Cogito-ergo-sum25/Single-lead-electrocardiograph-with-PCB-design/media/WhatsApp Image 2026-02-04 at 1.03.57 AM (1).jpeg

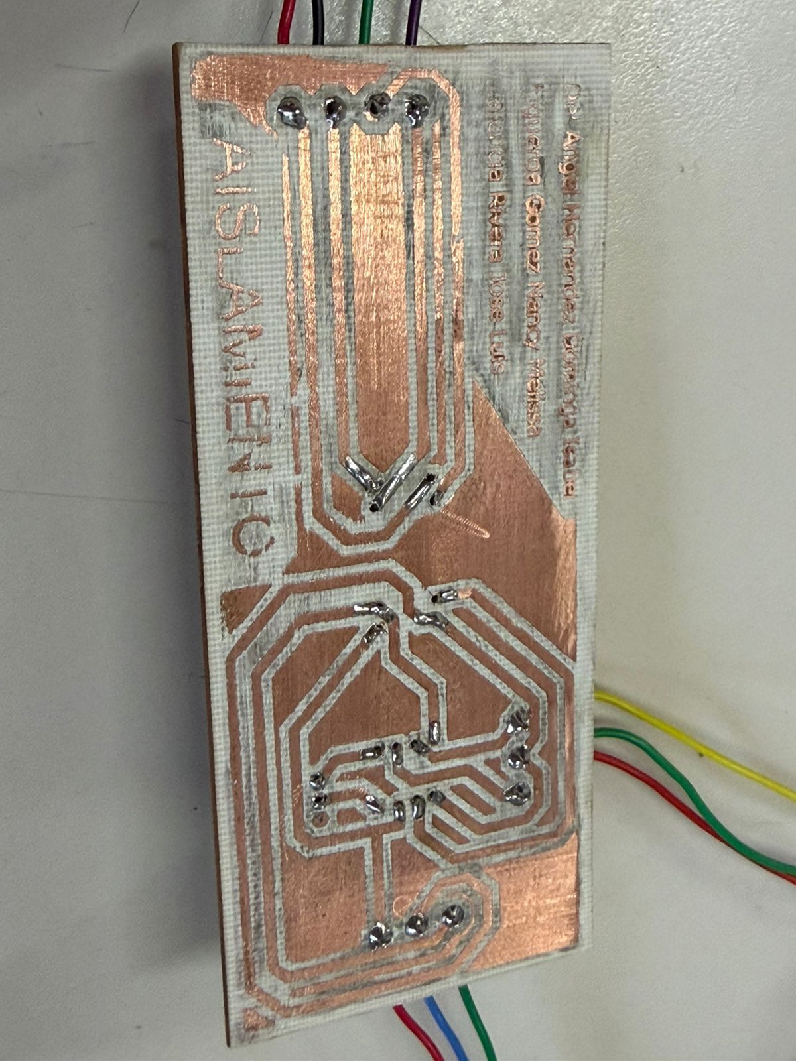
media/WhatsApp Image 2026-02-04 at 1.03.57 AM (1).jpeg
