Cogito-ergo-sum25/Single-lead-electrocardiograph-with-PCB-design/docs/PROYECTO_BIO_I.pdf

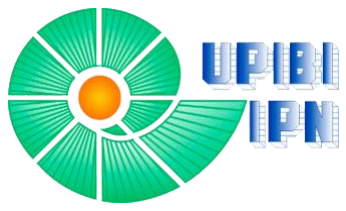
[picture p3: figure]

I. OBJETIVOS

General:

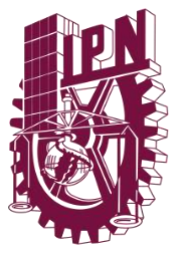
[picture p4: figure]

## INSTITUTO POLITÉCNICO NACIONAL

# Unidad Profesional Interdisciplinaria de Biotecnología

# Bioinstrumentación I

# Laboratorio de Bioinstrumentación I

# Proyecto

# Electrocardiógrafo de una derivación con diseño en PCB

# Presenta:

# Valencia Rivera Jose Luis

Implementar un sistema de adquisición de señales electrocardiográficas (ECG) enfocado en la detección y visualización de la Derivación I, integrando una etapa de paciente (amplificación y aislamiento) en circuito impreso (PCB) y una etapa de procesamiento de señal (filtrado) en protoboard para su análisis en osciloscopio.

Específicos:

- Construir la etapa de paciente en circuito impreso (PCB), incorporando el amplificador de instrumentación y el circuito de aislamiento para garantizar la seguridad y la integridad de la señal primaria.
- Acondicionar la señal biomédica mediante la
implementación | de | filtros | activos | en
protoboard (considerando la circuitería previa) para atenuar ruido y frecuencias no deseadas.
- Integrar las etapas de pre-amplificación y filtrado para obtener una señal limpia y estable correspondiente a la Derivación I.
- Visualizar y validar la señal de salida utilizando un osciloscopio, verificando que la morfología del complejo QRS y las ondas P y T sean legibles y correspondan a una señal fisiológica real.

II. FUNDAMENTO TEÓRICO

### 1. La Señal Bioeléctrica del Corazón

(ECG)

El Electrocardiograma (ECG) registra la actividad eléctrica del corazón generada en el nódulo sinoauricular y propagada por el miocardio. Dado que esta señal en superficie es de muy baja amplitud (0.5 mV – 5 mV) y baja frecuencia (0.05
Hz | – | 100 | Hz), | requiere | etapas | de
acondicionamiento precisas.
- Derivación I de Einthoven: A diferencia de otras configuraciones, la práctica actual se centra en la Derivación I. Esta configuración bipolar mide la diferencia de potencial entre el brazo izquierdo (LA) (electrodo positivo) y el brazo derecho (RA) (electrodo negativo).
- | Vector | Cardíaco: Esta | derivación
observa la actividad eléctrica del corazón desde una perspectiva lateral superior, siendo fundamental para el cálculo del eje eléctrico del corazón junto con las otras derivaciones estándar. [1]

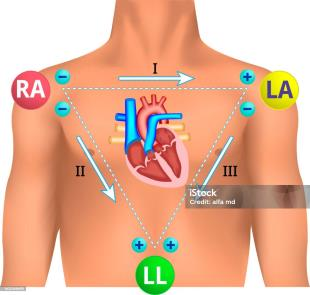
[picture p5: figure]

### Figura 1. ECG de derivaciones estándar de las

extremidades.

### 2. Aislamiento y Seguridad Eléctrica

(ISO124P)

El aislamiento galvánico sigue siendo el pilar de seguridad más crítico en la etapa de paciente ("Patient Stage"). Su función es proteger al usuario de corrientes de fuga provenientes de la red eléctrica.

- Prevención de Microshock: Se debe evitar que corrientes del orden de microamperios (μA) atraviesen el tórax del paciente, ya que podrían inducir fibrilación ventricular.
- Implementación con ISO124P: Para esta práctica se utiliza el amplificador de aislamiento ISO124P. Este dispositivo transmite la señal a través de una barrera
capacitiva | interna, | creando | una
separación óhmica total entre el "Lado Paciente" (flotante) y el "Lado Sistema" (tierra de los filtros y osciloscopio). Esto asegura el cumplimiento de normativas de seguridad biomédica. [2]

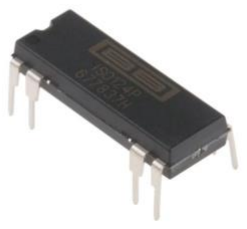
[picture p6: figure]

Figura 2. ISO124P.

### 3. Integridad de Señal en Circuito

Impreso (PCB)

La transición del diseño en protoboard a Circuito Impreso (PCB) en la etapa de pre-amplificación y aislamiento responde a la necesidad de mejorar la Relación Señal-Ruido (SNR) sin depender de blindajes externos voluminosos.

- | Reducción | de | Parásitos: Los
| protoboards | introducen | capacitancias
parásitas (aprox. 2-5 pF entre líneas) y resistencias de contacto variables que pueden formar filtros no deseados o acoplar ruido de alta frecuencia. El PCB elimina estos problemas mediante pistas de cobre fijas y soldadas.
- Minimización del Efecto Antena: Al diseñar el PCB, las pistas que transportan la señal débil del paciente se mantienen lo más cortas posible. Esto reduce la inductancia de la pista y su capacidad para
captar | interferencia | electromagnética
(EMI) del ambiente (como la línea de 60 Hz), actuando como una "mejora de blindaje intrínseca" en comparación con los cables largos ("latiguillos") usados en
| protoboard. [3]

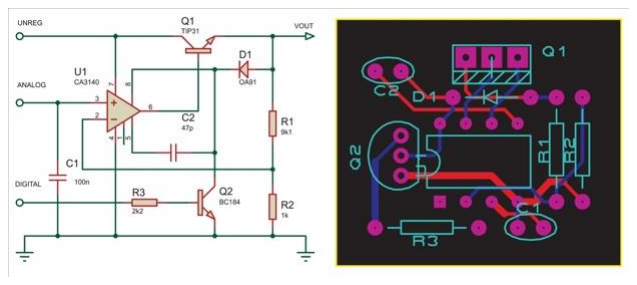
[picture p7: figure]

Figura 3. Ejemplo de diseño en PCB.

III. MEMORIA DE CALCULO

### 1. Filtro pasa banda fc= 500mHz a 150Hz

Requerimientos:

fc = 500 mHz a 150Hz

Escogiendo la siguiente tipología:

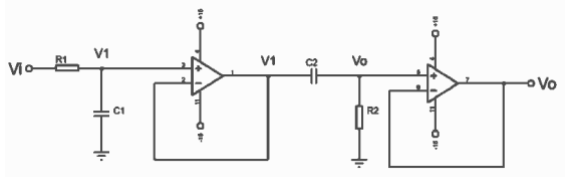
[picture p8: figure]

### Figura 4 “Filtro Pasa-Banda resultante de la cascada de Pasa-Bajas y Pasa-Altas”

Procedemos a obtener la función de transferencia, obteniendo ecuaciones de los nodos:

Vi − V1
R1

− sC1V1 = 0 (1)

(V1 − V0

)sC2 −

V0
R2

= 0 (2)

Despejando V1
Vi

de (1):

Vi (

1
R1

) − V1 (

1
R1

+ sC1) = 0

Vi (

1
R1

) = V1 (

1
R1

+ sC1)

V1
Vi

=

1
R1
1
R1

+ sC1

∗

R1
R1

V1
Vi

=

1
sC1 + 1

(3)

Despejando V0
V1

de (2):

V1

(sC2

) − V0 (sC2 +

1
R2

) = 0

V1

(sC2

) = V0 (sC2 +

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
+ sC2

∗

R2
R2

V0
V1

=

sC2R2
sC2R2 + 1

(4)

Multiplicando (3) y (4), para obtener la función de transferencia total:

V1
Vi

∗

V0
V1

= (

1
sC1 + 1

) (

sC2R2
sC2R2 + 1

)

V0
Vi

=

sC2R2
s

2C1R1C2R2 + s(C1R1 + C2R2
) + 1

(5)

De la ecuación (3) deducimos que:

w0 =

1
C1R1

Y en términos de la frecuencia:

f =

1
2πC1R1

(6)

De la misma forma para la ecuación (4):

w0 =

1
C2R2

∴ f =

1
2πC2R2

(7)

Despejando las resistencias de las ecuaciones (6) y (7):

R1 =

1
2πC1f1

(8)

R2 =

1
2πC2f2

(9)

Sustituyendo valores en las ecuaciones (8) y (9) sabiendo que:

f1 = 150Hz

C1 = 46nF

f2 = 500mHz

C2 = 349nF

R1 =

1
2π(46nF)(150Hz)

= 22575.16 Ω

R2 =

1
2π(500mHz)(349nF)

= 912062.71 Ω

Diagrama esquemático:

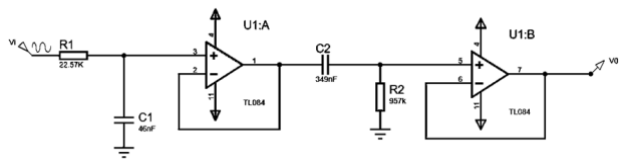
[picture p9: figure]

### Figura 5. “Diagrama de filtro pasa banda”

### 2. Filtro rechaza banda 60Hz Q=6

Requerimientos

fc = 60 Hz y Q = 6

Proponiendo un ancho de banda de 10Hz para que resulte el factor de calidad de 6 tenemos:

BW = 10 ℎz

fCL = 55 ℎz

fCH = 65 ℎz

fr = √fCL ∙ fCH = √55 ∙ 65 = 59.8

Confirmando el factor de calidad tenemos

Q =

fr
BW =

59.8
10 = 5.98 ≈ 6

Con el ancho de banda conseguido y el factor de calidad comprobado procedemos a realizar el cálculo de las 3 resistencias:

Proponiendo:
C1 = C2 = 100nF

Tenemos:

R1 =

1
2(2πfc

)QC1

=

1
4π(60)(6)(100nF)

R1 = 2.21 kΩ

R2 =

2Q
(2πfc

)C1

=

2 ∗ 6
(2π ∗ 60)(100nF)

R2 = 318.31 kΩ

R3 =

R1R2
R1 + R2

=

(2.21 k)(318.31 k)
(2.21 k) + (318.31 k)

R3 = 2.2 kΩ

C3 = 2C1 = 2(100nF) = 200nF

Finalmente:

C1 = C2 = 100nF

C3 = 200nF

R1 = 2.21 kΩ

R2 = 318.31 kΩ

R3 = 2.2 kΩ

Diagrama esquemático:

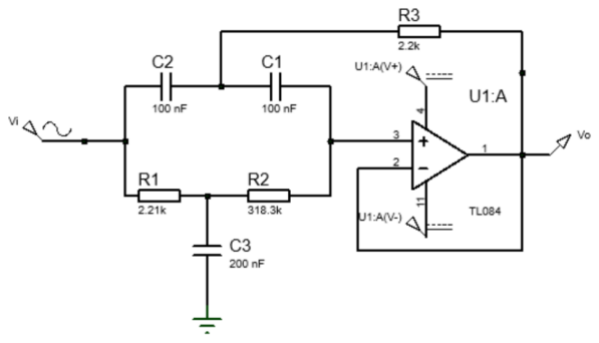
[picture p10: figure]

### Figura 6 "Diagrama de filtro rechaza banda"

3. Amplificador | de | instrumentación
integrado (AD620).

Requerimientos:

G = 1000

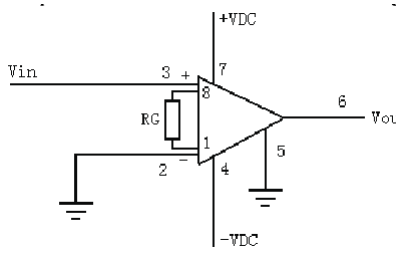
[picture p11: figure]

### Figura 7. Pinout del amplificador de instrumentación

AD620.

La ganancia del AD620 según el datasheet se calcula con la siguiente formula:

G = 1 +

49.9kΩ
RG

(1)

- Resistencia externa conectada entre los pines 1 y 8.
- 49.4 kΩ: sumatoria de las resistencias internas R1+ R2, ya calibradas por el fabricante.

Para la ganancia de 1000 despejamos:

RG =

49.9kΩ
1000 − 1

≈ 49.45kΩ (2)

Ecuación de salida Vout:

VOUT = G ∙ (VIN+ − VIN−) + VREF (3)

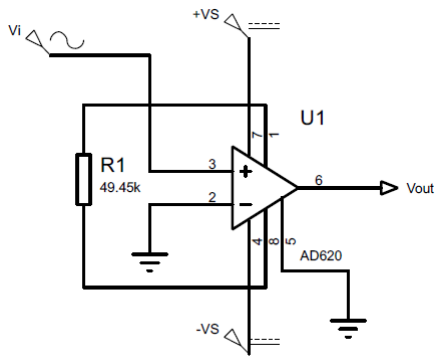
[picture p12: figure]

### Figura 8. Diagrama del Amplificador de

instrumentación integrado AD620.

IV. RESULTADOS

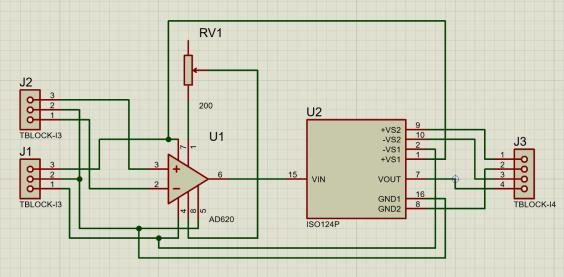
[picture p13: figure]

### Figura 10. Diseño del circuito de la etapa de paciente

realizado en Proteus.

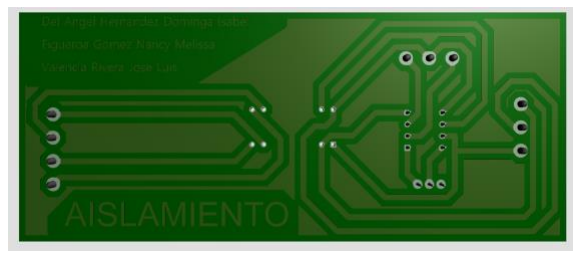
[picture p14: figure]

### Figura 11. Diseño digital del PCB correspondiente a

la etapa de paciente.

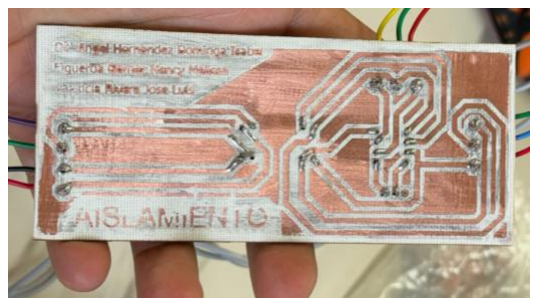
[picture p15: figure]

### Figura 12. Circuito físico en PCB de la etapa de paciente

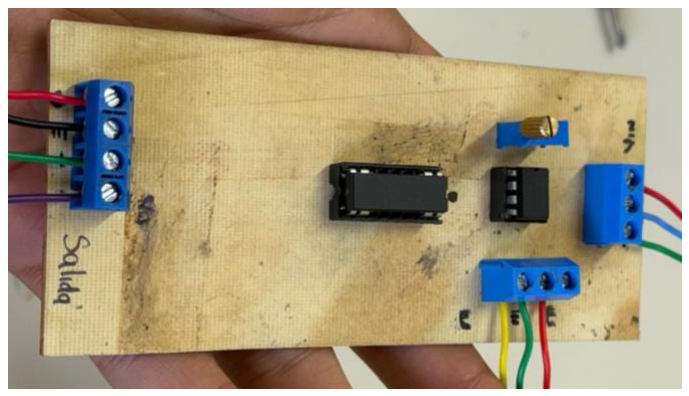
[picture p16: figure]

### Figura 13. Circuito físico en PCB de la etapa de

paciente con AD620 e ISO124.

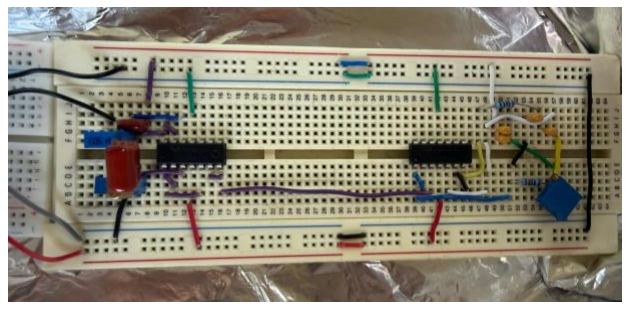
[picture p17: figure]

### Figura 14. Implementación física de los filtros pasa

banda y rechaza banda en protoboard.

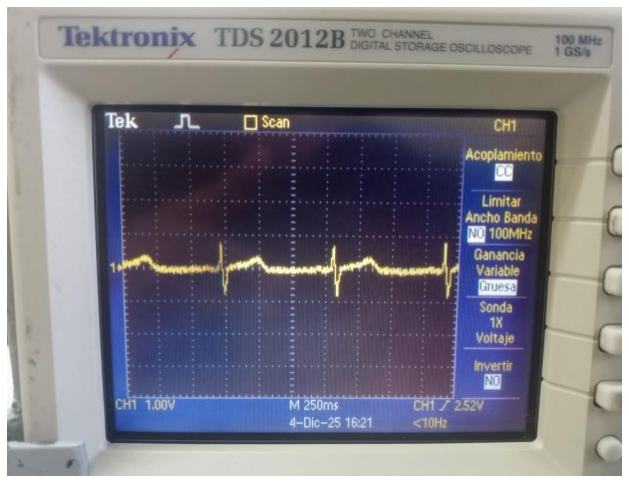
[picture p18: figure]

### Figura 15. Señal electrocardiográfica (ECG) obtenida tras las etapas de amplificación, filtrado y

aislamiento.

V. ANÁLISIS DE RESULTADOS
1. Amplificación y aislamiento.

En la Figura 13 se muestra el circuito físico en PCB que integra el amplificador de instrumentación AD620 junto con el amplificador de aislamiento ISO124. Al observar la señal en el osciloscopio, el ECG presentó una amplitud adecuada, lo que confirma que la ganancia del AD620 fue suficiente para amplificar la señal sin introducir distorsión. La implementación en PCB permitió una mayor estabilidad y menor susceptibilidad al ruido en comparación con el montaje previo en protoboard,
validando | el | correcto | funcionamiento | del
aislamiento y la seguridad eléctrica del sistema.

### 2. Filtrado de señal

El circuito de filtros pasa banda y rechaza banda, mostrado en la Figura 14, permitió conservar las componentes fisiológicas del ECG dentro del rango esperado, atenuando la interferencia de la red eléctrica y el ruido fuera de banda. La señal obtenida mantuvo la forma característica de las ondas P, QRS y T, facilitando su identificación de manera clara y consistente.

### 3. Integración del sistema

La integración de la etapa de paciente en PCB con los filtros implementados en protoboard permitió obtener una señal electrocardiográfica estable y legible, como se observa en la Figura 15. En comparación con la práctica anterior, el sistema mostró una mejora en la calidad de la señal y en su
reproducibilidad, | demostrando | que | la
implementación en PCB representa una solución más robusta para la adquisición de señales biomédicas en condic

VI. REFERENCIAS

[1] J. G. Webster, Medical Instrumentation: Application and Design, 4th ed. Hoboken, NJ, USA: John Wiley & Sons, 2009.
[2] B. H. Brown and R. H. Smallwood, Medical Physics and Biomedical Engineering. Boca Raton, FL, USA: CRC Press, 2011.
[3] J. P. D. A. Dinis, J. M. A. Costa, and A. C. T. A. T. Dinis, “Design of a Bio-Amplifier for ECG Monitoring,” IEEE Trans. Instrum. Meas., vol. 60, no. 12, pp. 3845–3852, Dec. 2011.
