Cogito-ergo-sum25/Single-lead-electrocardiograph-with-PCB-design/media/Captura de pantalla 2026-02-04 010605.jpg

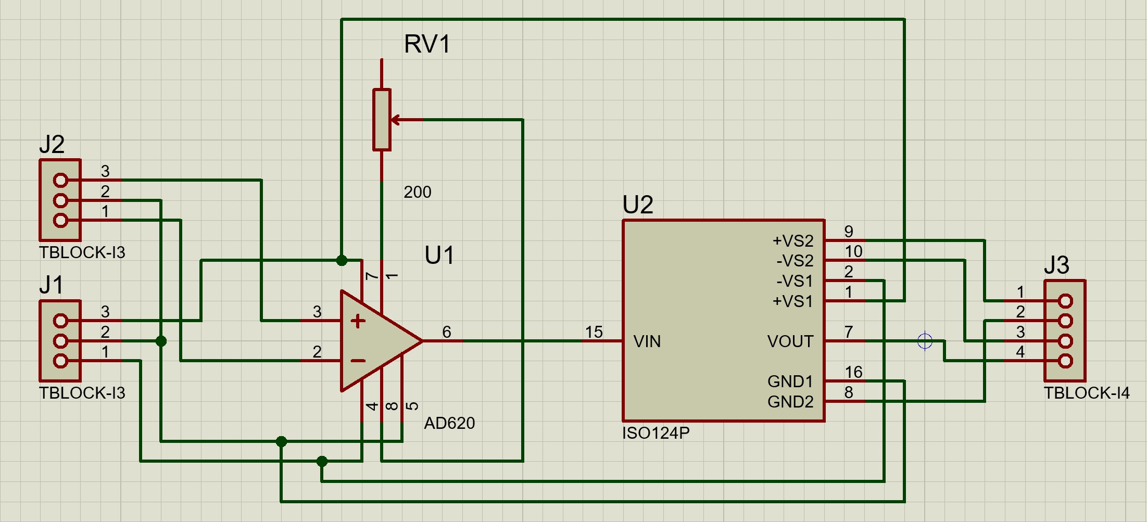
media/Captura de pantalla 2026-02-04 010605.jpg
