Cogito-ergo-sum25/Single-lead-electrocardiograph-with-PCB-design/(list of files, drawings)

Other design files:
design/BIO_I_ultima.pdsprj
